TakumaOnishi/Fish_Keyboard/README.md

# おさかなキーボード<br>
<br>
ホームページ：https://o24.works/fish/<br>
販売店ページ：https://shop.yushakobo.jp/products/9519<br>
ビルドガイド：https://scrapbox.io/fish-keyboard/おさかなキーボードを作る<br>
コミュニティ：https://discord.gg/9BHjMCMwHJ
