TakumaOnishi/Fish_Keyboard/KEYCAP/README.md

`fish_keycap.stl` - 純粋にキーキャップのみのモデル  
`fish_keycap_connected.stl` - ランナーでひと繋ぎにしたモデル  
`fish_keycap_clustered_1〜4.stl` - JLC3DPに発注するために、８個ずつひと繋ぎにしたモデル  
`fish_keycap_supported.stl` - Elegoo Saturnで自家生産するために、サポートをつけたモデル  
`fish_keycap_thin_supported.stl` - 印刷が太りがちな特定の業者に発注するために、上記のステム部分を少し痩せさせたモデル
