TakumaOnishi/Fish_Keyboard/PLATE/README.md

## Z軸寸法  
・板の寸法は、よこ121.7 * たて80.0 * 厚み2.0mm（業者にでかい板一枚から切り出してもらう関係で、縦横は半端な寸法になっている）  
・魚型のアウトラインは上面から2.0mm切削（貫通）  
・ネジ頭の窪み（ø4.2mm）は上面から1.2mm切削  
・↑の中にあるネジ穴（ø2.2mm）は1.2mm切削したところから0.8mm切削（貫通）  
・ゴム足用の窪み（ø8.2mm）は上面から1.0mm切削  
・反対側も左右対に  
・板の歪みの影響を抑えるため、データは別々にして片方ずつ切削する
