TakumaOnishi/Fish_Keyboard/PCB/note.md

## 取り付ける部品

キースイッチ  
・イメージ：https://nuphy.com/collections/switches/products/nuphy-daisy-l48-switches  
・データシート：https://cdn.shopify.com/s/files/1/0268/7297/1373/files/gateron-brown-spec-sheet.pdf?v=1657696307  
  
Pro Micro （USB-C 互換品）  
・イメージ：https://ja.aliexpress.com/item/32888212119.html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  
  
TRRSジャック  
・イメージ：https://ja.aliexpress.com/item/33029465106.html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  

## 回路

  
  
16個のキースイッチにはそれぞれ、指向性のない２本の足があります。片方はすべてGNDに繋ぎ、もう片方はPro Microの18個のポートのうち固有の16個に繋ぎます。
どれをどれに繋げるかはファームウェア上で指定を書き換えられるので、配線の都合で変えてもいいです。左右違ってもいいです。  

TRRSジャックは左右通信に使います。両側のPro Microの  
1.GND  
2.VCC  
3.PD2（余る２ポートのうちひとつ、左右で同じ番号のものであればこちらも変えてよい）  
どうしをTRRSケーブルを通して繋ぎます。TRRSジャックの穴のうち一つ（一番外側のやつ）は使いません。 
  
・Pro Microのピン配置：https://cdn.sparkfun.com/datasheets/Dev/Arduino/Boards/ProMicro16MHzv1.pdf  
・左右通信規格の参考：https://docs.qmk.fm/#/feature_split_keyboard?id=split-keyboard  

## その他

・親指の２キーは組み立て時にハンダゴテが入らなさそうなので、独立のPCBは作らず、直付けした導線をPCB下側の４穴に引っ張ってくることにしました。
・キースイッチとTRRSジャックの足およびPro Microのピンが左右対称ではないので、左右別で作ってほしいです。  
・組み立て時にわかりやすいように、表と裏で色を変えるか、表に「left」「right」などと書いてほしいです。  
  
・Z軸正の領域から見える面が組み立て時の表です。
・組み立ての段取りは
1. PCBの表側にあらかじめTRRSジャックとPro Micro用ピンヘッダーをはんだ付け
2. 裏からキースイッチを嵌めたボディに入れ込んで、スイッチの足とはんだ付け
3. ピンヘッダーにPro Microを裏向きではんだ付け
を想定しています。
