TakumaOnishi/Fish_Keyboard/PCB/BOM.csv

Comment | Designator | Footprint | JLCPCB Part #（optional）
Diode | D1-16 | rocal-library:SOD-323 | C2128
