TakumaOnishi/Fish_Keyboard/BODY/fish_body_both_250325.stl

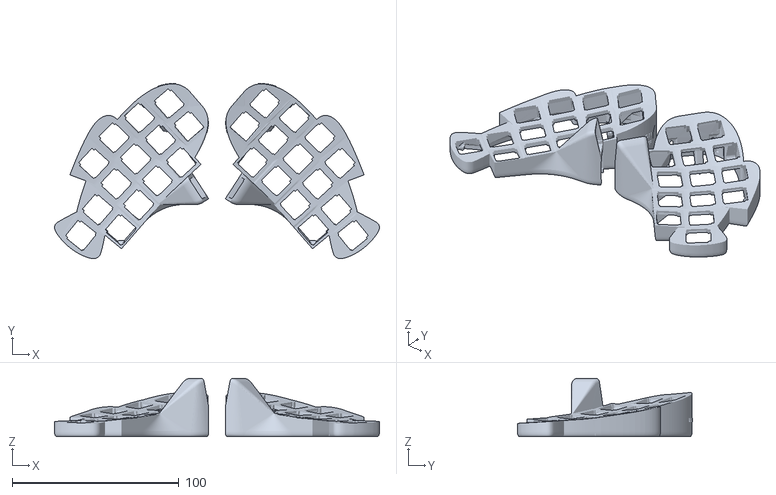
[picture p1: CAD file, 2025-03-24]
BODY/fish_body_both_250325.stl
195.2 x 105.2 x 35.1
