TakumaOnishi/Fish_Keyboard/KEYCAP/fish_keycap_clustered_4.stl

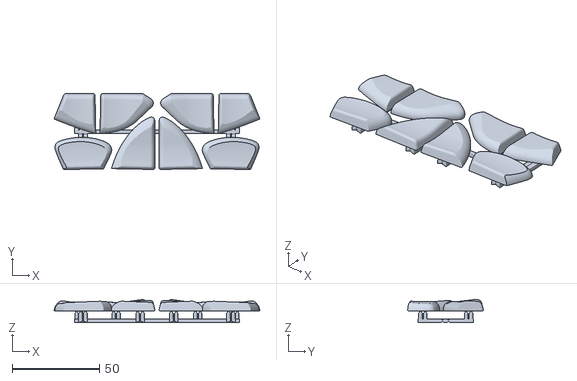
[picture p2: CAD file, 2025-03-18]
KEYCAP/fish_keycap_clustered_4.stl
117.8 x 43.5 x 13.2
