TakumaOnishi/Fish_Keyboard/PLATE/fish_plate_left.stp

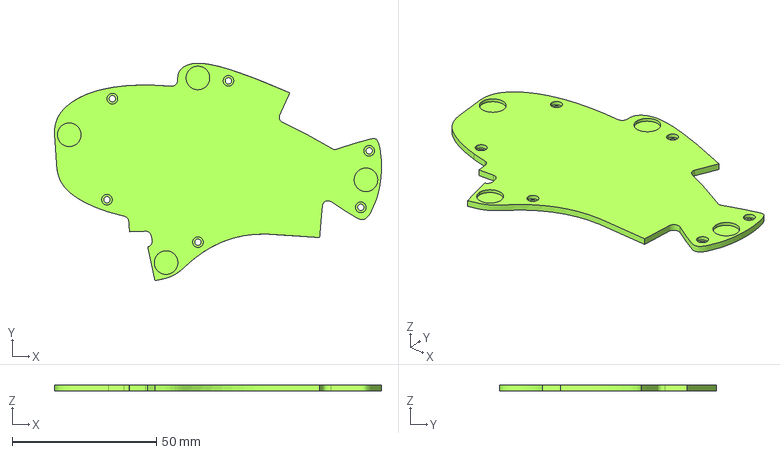
[picture p3: CAD file, 2024-12-25]
PLATE/fish_plate_left.stp
113.4 x 75.4 x 2.00 mm
