TakumaOnishi/Fish_Keyboard/BODY/fish_body_right_250325.stl

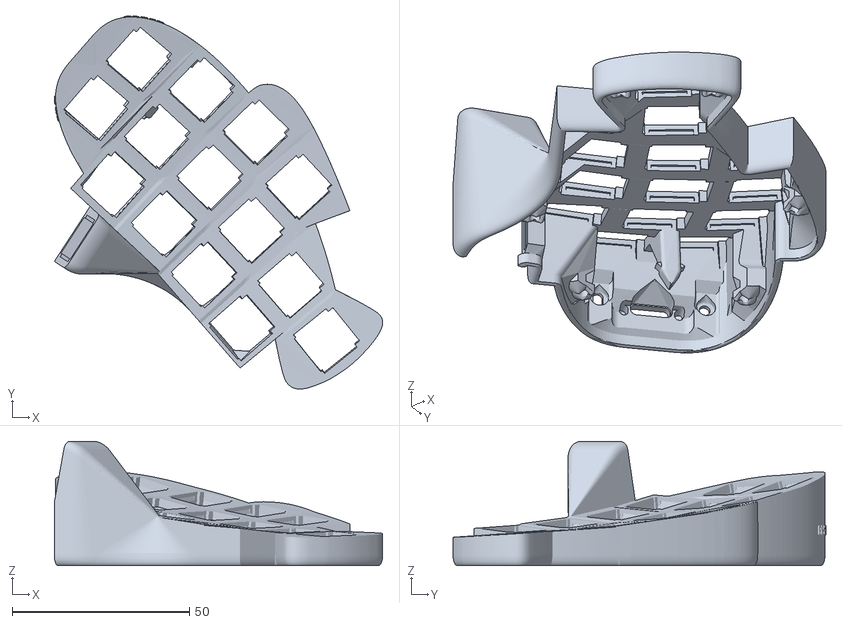
[picture p4: CAD file, 2025-03-24]
BODY/fish_body_right_250325.stl
92.6 x 105.2 x 35.1
