TakumaOnishi/Fish_Keyboard/KEYCAP/fish_keycap_clustered_2.stl

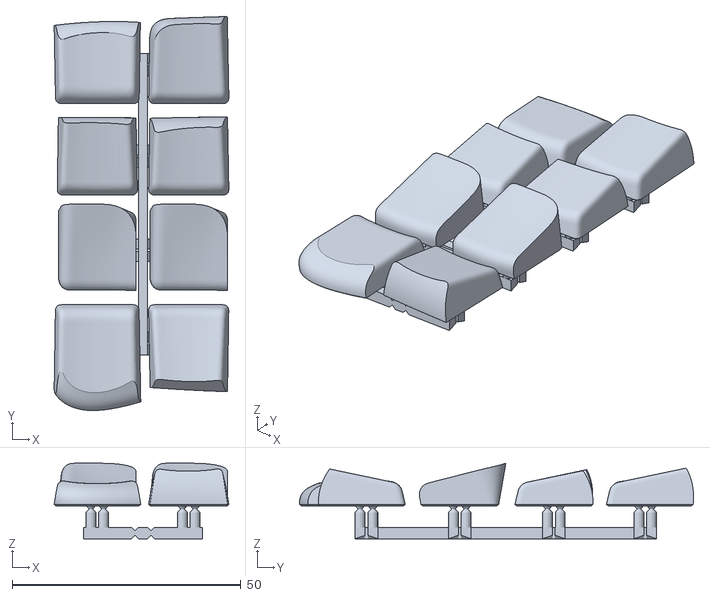
[picture p5: CAD file, 2025-02-28]
KEYCAP/fish_keycap_clustered_2.stl
38.2 x 86.1 x 16.5
