TakumaOnishi/Fish_Keyboard/PLATE/plate_outline.dxf

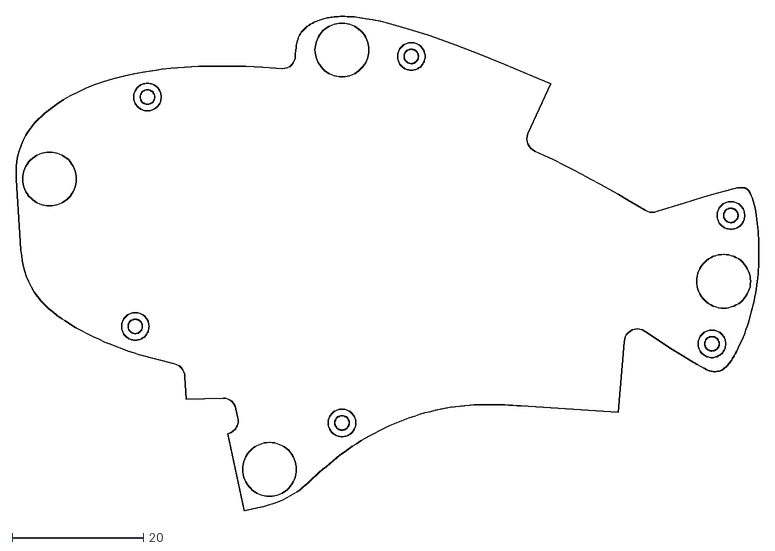
[picture p6: CAD file, 2023-11-03]
PLATE/plate_outline.dxf
113.4 x 75.4
