TakumaOnishi/Fish_Keyboard/KEYCAP/fish_keycap_clustered_1.stl

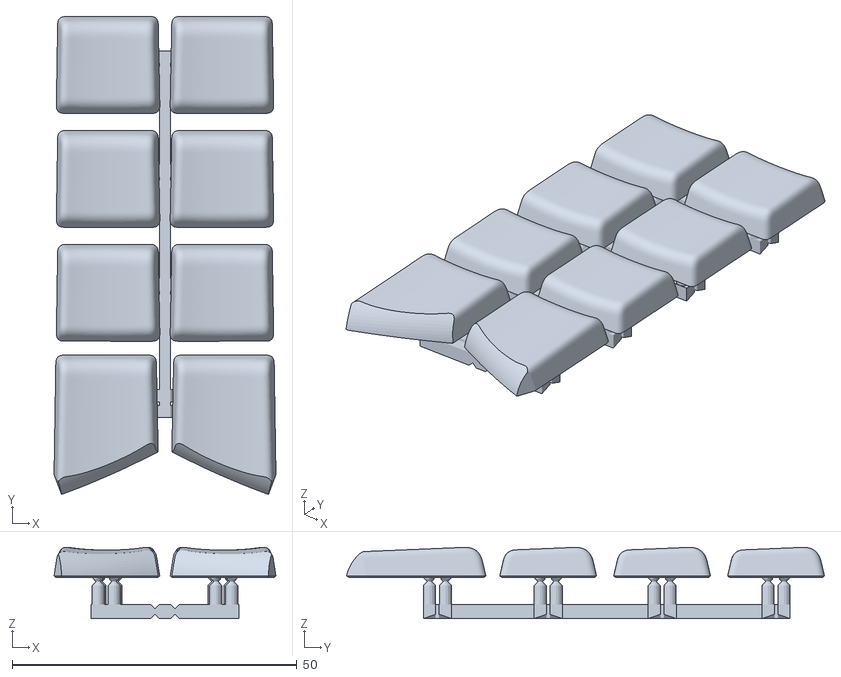
[picture p7: CAD file, 2025-02-28]
KEYCAP/fish_keycap_clustered_1.stl
39.0 x 83.9 x 12.5
