TakumaOnishi/Fish_Keyboard/(list of files, cad)

Other CAD files:
PLATE/fish_plate_right.stp
BODY/fish_body_left_250325.stl
KEYCAP/fish_keycap_clustered_3.stl
KEYCAP/fish_keycap_thin_supported.stl
