TakumaOnishi/Fish_Keyboard/(commit log)

2023-05-30 外形と穴の輪郭以外削除
    [outline.dxf]
2023-06-01 dxf修正
    [outline.dxf]
2023-06-15 拡張されたPCBの輪郭
    [ble_outline.dxf]
2023-06-17 XIAOのピン位置を追加
    [outline_xiao.dxf]
2023-07-09 全面タイプのフタ
    [futa_big.dxf]
2023-07-09 口を平らに
    [futa_big.dxf]
2023-07-09 口を平らにする
    [futa_big.dxf]
2023-07-12 頭の曲線を直したフタの輪郭
    [plate_outline_fixed.dxf]
2023-08-11 PCB輪郭USB幅
    [pcb_outline.dxf]
2023-08-12 FCP輪郭修正
2023-08-14 取り付けイメージ更新
2023-08-14 上げ直し
    [pcb_outline.dxf]
2023-08-14 outline上げ直し
    [fpc_outline.dxf, pcb_outline.dxf]
2023-09-09 beamo用カットライン
2023-09-14 BLEプロト用プレート
    [plate_outline_beta.dxf]
2023-10-27 外形を修正
    [outline_left.dxf, outline_right.dxf]
2023-10-31 修正後の外形を追加
    [outline_left_new.dxf, outline_rightt_new.dxf]
2023-11-03 プレート輪郭更新
    [plate_outline.dxf]
2023-11-03 基板外形を最終調整
    [outline_left_final_.dxf, outline_right_final_.dxf]
2023-11-15 refactor PCB dir
    [outline_left_final_.dxf, outline_right_final_.dxf]
2023-11-15 refactor PCB dir 2
    [left_BOM.csv, outline_left_final_.dxf, outline_right_final_.dxf, outline_wing.dxf, right_BOM.csv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]
2025-03-24 Add files via upload
    fixed irregular faces
    [fish_body_both_250325.stl, fish_body_left_250325.stl, fish_body_right_250325.stl]
2025-04-04 ZMK Studioに対応
